dingjamesj/electronic-trombone/Flowchart.pdf

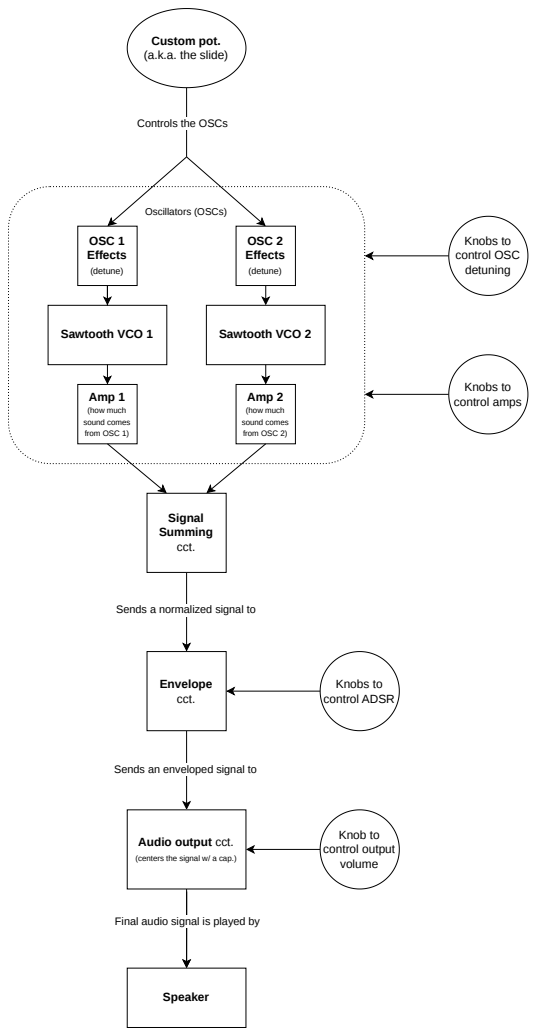
[picture p1: page 1]
Sawtooth VCO 1; Sawtooth VCO 2; Amp 1; (how much sound comes from OSC 1); Amp 2; (how much sound comes from OSC 2); OSC 1 Effects; (detune); OSC 2 Effects; Oscillators (OSCs); Signal Summing cct.; Envelope cct.; Speaker; Knobs to control ADSR; Custom pot. (a.k.a. the slide); Knobs to control OSC detuning; Knobs to control amps; Knob to control output volume

Controls the OSCs

Sends a normalized signal to

Sends an enveloped signal to

Audio output cct.

(centers the signal w/ a cap.)

Final audio signal is played by
