dingjamesj/electronic-trombone/SPICE simulation.asc

A1: schmtinv; Vhigh=9 Vt=4.45 Vh=.85 Trise=.1u Tfall=.1u
A2: schmtinv; Vhigh=9 Vt=4.45 Vh=.85 Trise=.1u Tfall=.1u
C1: cap; 2.2n
C3: cap; 2.2n
C_f: cap; 1µ
D1: diode; 1N4148
D2: diode; 1N4148
PotLeft_Coarse1: res; 49k
PotLeft_Coarse2: res; 50k
PotLeft_Fine1: res; 50k
PotLeft_Fine2: res; 50k
PotLeft_Mixer: res; 500k
PotRight_Coarse1: res; 51k
PotRight_Coarse2: res; 50k
PotRight_Fine1: res; 50k
PotRight_Fine2: res; 50k
PotRight_Mixer: res; 500k
Q1: npn
Q2: pnp
Q3: npn
Q4: pnp
R_amp1: res; 33k
R_amp2: res; 100k
R_Coarse1: res; 100k
R_Coarse2: res; 100k
R_CurrentLimit: res; 20k
R_f: res; 100k
R_Fine1: res; 1Meg
R_Fine2: res; 1Meg
R_In1: res; 100k
R_In2: res; 100k
R_Large1: res; 1Meg
R_Large2: res; 1Meg
TH_Coarse1: res; 10k
TH_Coarse2: res; 10k
TH_Fine1: res; 10k
TH_Fine2: res; 10k
TH_In1: res; 10k
TH_In2: res; 10k
U1: UniversalOpAmp2
U2: UniversalOpAmp2
U3: UniversalOpAmp2
U5: UniversalOpAmp2
V1: voltage; 12
V2: voltage; 12
V3: voltage; 12
V4: voltage; 12
V5: voltage; 12
V6: voltage; 12
V7: voltage; 12
V8: voltage; 12
V9: voltage; 12
V10: voltage; 12
V11: voltage; 12
V12: voltage; 12
V15: voltage; 12
V16: voltage; 12
V_In: voltage; 5
Named nets: 0, v1, v2, out, v4, v3
.tran 0 0.5 0.495
.ic V(v1) 0
.ic V(v2) 0
.ic V(v3) 0
.ic V(v4) 0
