dingjamesj/electronic-trombone/SPICE Simulations/Power.asc

R1: res; 25k
R2: res; 75k
R3: res; 10k
R4: res; 10k
R5: res; 10k
R6: res; 10k
R7: res; 1k
R8: res; 99999
R9: res; 1
U1: UniversalOpAmp2
U2: UniversalOpAmp2
U3: UniversalOpAmp2
V1: voltage; 9
V2: voltage; -9
V3: voltage; 5
V4: voltage; 2.5
Named nets: MuxOut, 0, VCC, VEE, VDD, Pot-, Pot+, PotOut
The custom slide pot
.tran 0 0.5 0
