dingjamesj/electronic-trombone/SPICE Simulations/EnvelopeGenerator.asc

C1: cap; 1µ
C2: cap; 1µ
C3: cap; 1µ
C4: cap; 1µ
C5: cap; 10n
D1: diode; 1N4148
D2: diode; 1N4148
D3: diode; 1N4148
D4: diode; 1N4148
D5: diode; 1N4148
D6: diode; 1N4148
D7: diode; 1N4148
D10: diode; 1N4148
D11: diode; 1N4148
R1: res; 60k
R2: res; 60k
R3: res; 100k
R4: res; 100k
R5: res; 100k
R6: res; 100k
R7: res; 5k
R8: res; 100k
R9: res; 50k
R10: res; 200k
R11: res; 1k
R12: res; 1k
R13: res; 50k
R14: res; 50k
R15: res; 100k
R16: res; 100k
R17: res; 150k
R18: res; 150k
R19: res; 100k
R20: res; 100k
R21: res; 100k
R22: res; 12k
R23: res; 75k
U1: UniversalOpAmp2
U2: UniversalOpAmp2
U3: UniversalOpAmp2
U4: UniversalOpAmp2
U5: UniversalOpAmp2
U8: UniversalOpAmp2
U9: UniversalOpAmp2
U10: UniversalOpAmp2
V1: voltage; 9
V2: voltage; 9
V3: voltage; PWL(0 -9 0.01m 0 0.3 4.5 1.2 -4.5 2 -9)
V4: voltage; PULSE(-9 0 0 0.01m 0.01m 1.2 2 1)
V5: voltage; PULSE(-9 0 0 0.01m 0.01m 0.1 0.2 4)
Named nets: VCC, VEE, 0, AmpSustain, FilterSustain, AmpOut, FilterOut, In, In0, ProcessedIn, AmpGoalVoltage, FilterGoalVoltage, In2
Sustain is half of VCC, decay is 0V
Amp Envelope
Filter Envelope
Low pass filter with two cutoff freqs depending on the difference between the goal voltage and the current output voltage.
Same as above
.tran 2
An input greater than -4.5V triggers the envelope generator.
-4.5V was chosen instead of 0V because some input signals will be 0V or less.
Recall that this input voltage is also the VCO's control voltage, and the VCO's control voltage can range all the way down to 0V.
Controls slope of the attack
Controls length & slope of decay and release
Controls length
Protects op amp input
from negative voltage swing
of the attack
Makes envelope go to sustain/base voltage
instead of VEE
Same here
These nodes are VCC during the attack, at the sustain voltage during sustain, and at GND otherwise.
It's the voltage that we're trying to "reach."
Test performance during repeated presses
Test performance under "test conditions"
i.e. a single, long pulse of one voltage
Test performance during slide movement
i.e. a single pulse with changing voltage
