dingjamesj/electronic-trombone/SPICE Simulations/Filter.asc

C1: cap; 1n
C2: cap; 1n
C3: cap; 1n
D1: diode; 1N4148
D2: diode; 1N4148
D3: diode; 1N4148
D4: diode; 1N4148
D5: diode; 1N4148
D6: diode; 1N4148
D7: diode; 1N4148
R1: res; 10k
R2: res; 1k
R6: res; 10k
R7: res; 10k
R9: res; 10k
R10: res; 10k
R11: res; 10k
R12: res; 10k
R13: res; 10k
U1: UniversalOpAmp2
U2: UniversalOpAmp2
U3: UniversalOpAmp2
U6: UniversalOpAmp2
U8: UniversalOpAmp2
V1: voltage; 0.5
V2: voltage; 9
V3: voltage; 9
V4: voltage; ""; AC 1
Named nets: 0, VCC, VEE, ControlIn, ProcessedControlIn, SignalIn, UnprocessedOut, Out
Control Processing
The Filter
Output Processing
This amplifies the signal into the required pp voltage and provides a voltage follower at the end.
Diode ladder
Attenuates the control signal such that its range satisfies the range required by the diode ladder.
.ac dec 100 1 100k
.step param ControlVoltage 0 1 0.1
