dingjamesj/electronic-trombone/SPICE Simulations/Oscillator.asc

A1: schmtinv; Vhigh=9 Vt=4.45 Vh=.85 Trise=.1u Tfall=.1u
A2: schmtinv; Vhigh=9 Vt=4.45 Vh=.85 Trise=.1u Tfall=.1u
C1: cap; 2.2n
C3: cap; 2.2n
C_f1: cap; 1µ
D1: diode; 1N4148
D2: diode; 1N4148
PotLeft_Coarse1: res; 50k
PotLeft_Coarse2: res; 50k
PotLeft_Fine1: res; 50k
PotLeft_Fine2: res; 50k
PotLeft_Mixer: res; 50k
PotRight_Coarse1: res; 50k
PotRight_Coarse2: res; 50k
PotRight_Fine1: res; 50k
PotRight_Fine2: res; 50k
PotRight_Mixer: res; 50k
Q1: npn
Q2: pnp
Q3: npn
Q4: pnp
R1: res; 90k
R2: res; 10k
R_Coarse1: res; 100k
R_Coarse2: res; 100k
R_Fine1: res; 1Meg
R_Fine2: res; 1Meg
R_In1: res; 100k
R_In2: res; 100k
R_Large1: res; 1Meg
R_Large2: res; 1Meg
R_Scaling1: res; 2.5k
R_Scaling2: res; 2.5k
TH_Coarse1: res; 10k
TH_Coarse2: res; 10k
TH_Fine1: res; 10k
TH_Fine2: res; 10k
TH_In1: res; 10k
TH_In2: res; 10k
U1: UniversalOpAmp2
U2: UniversalOpAmp2
U3: UniversalOpAmp2
U6: UniversalOpAmp2
V1: voltage; 3.5
V3: voltage; 7
V4: voltage; 7
Named nets: 0, v1, v2, Out, v4, v3, In1, In2, mixsum, VCC, VEE, In
.tran 0 5 4.98
