dingjamesj/electronic-trombone/SPICE Simulations/Amplifier.asc

C1: cap; 1µ
Q1: npn; 2N2222
Q2: npn; 2N2222
R1: res; 10k
R2: res; 2.7k
R3: res; 2.7k
R4: res; 100k
R5: res; 100k
R6: res; 10k
R7: res; 10k
R10: res; 100k
U1: UniversalOpAmp2
U2: UniversalOpAmp2
U3: UniversalOpAmp2
U4: UniversalOpAmp2
V1: voltage; 9
V2: voltage; -9
V3: voltage; SINE(0 5m 440)
V4: voltage; -1.5
Named nets: SignalIn, ControlIn, VCC, VEE, 0, Out
10mV pp
.tran 0 5 4.98
