dingjamesj/electronic-trombone/SPICE Simulations/Envelope Generator.asc

C1: cap; 1µ
C2: cap; 1µ
C3: cap; 1µ
D1: diode; 1N4148
D2: diode; 1N4148
D3: diode; 1N4148
D4: diode; 1N4148
D5: diode; 1N4148
D6: diode; 1N4148
D7: diode; 1N4148
D8: diode; 1N4148
D9: diode; 1N4148
R1: res; 50k
R2: res; 50k
R3: res; 100k
R4: res; 100k
R5: res; 100k
R6: res; 100k
R7: res; 10k
R8: res; 100k
R9: res; 10k
R10: res; 100k
R11: res; 1k
R12: res; 1k
R13: res; 50k
R14: res; 25k
R15: res; 50k
R16: res; 25k
U1: UniversalOpAmp2
U2: UniversalOpAmp2
U3: UniversalOpAmp2
U4: UniversalOpAmp2
U5: UniversalOpAmp2
U6: UniversalOpAmp2
U7: UniversalOpAmp2
V1: voltage; 9
V2: voltage; 9
Named nets: In, TriggerRef, VCC, VEE, 0, Sustain1, Sustain2, Out1, Out2
Set to 4.5 V
Set to half the maximum (-3 dB)
Also set to half the maximum (-3 dB)
Envelope Output 1
Envelope Output 2
Controls release & decay
According to Mortiz Klein, controls attack. However, the simulation disagrees.
Same as above
Controls how long the envelope will initially increase for (i.e. controls attack)
