dingjamesj/electronic-trombone/KiCad/Buttons/Buttons.kicad_pcb

## KiCad design KiCad/Buttons/Buttons.kicad_pcb (2026-08-21)

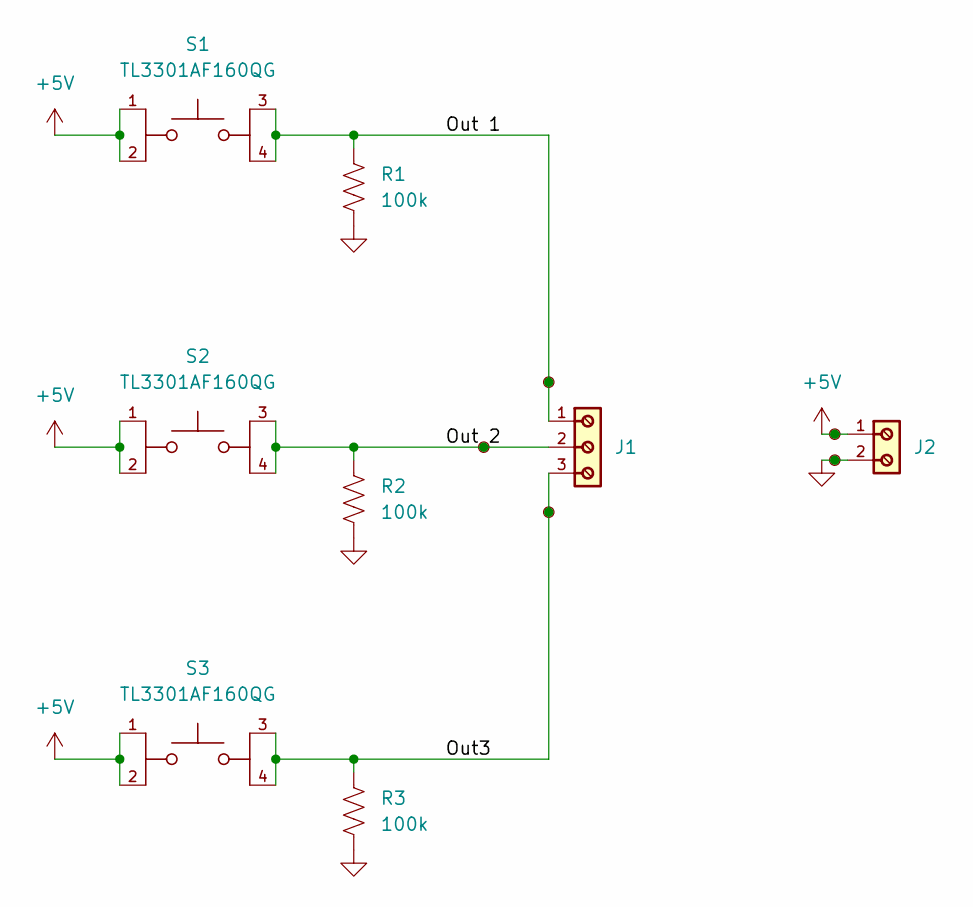
[picture p2: schematic Buttons.kicad_sch]

Parts:
J1: 691137710003
J2: 691137710002
R1, R2, R3: 100k; R_Axial_DIN0207_L6.3mm_D2.5mm_P7.62mm_Horizontal
S1, S2, S3: TL3301AF160QG; SW_TL3301AF160QG; PARTREV E
TP1, TP2, TP3, TP4, TP5: TestPoint_Small; TestPoint_Keystone_5000-5004_Miniature

Connections:
+5V: J2.1, S1.1, S1.2, S2.1, S2.2, S3.1, S3.2, TP2.1 (1_1)
/Out3: J1.3, R3.1, S3.3, S3.4, TP5.1 (1_1)
/Out 1: J1.1, R1.1, S1.3, S1.4, TP3.1 (1_1)
/Out 2: J1.2, R2.1, S2.3, S2.4, TP4.1 (1_1)
GND: J2.2, R1.2, R2.2, R3.2, TP1.1 (1_1)

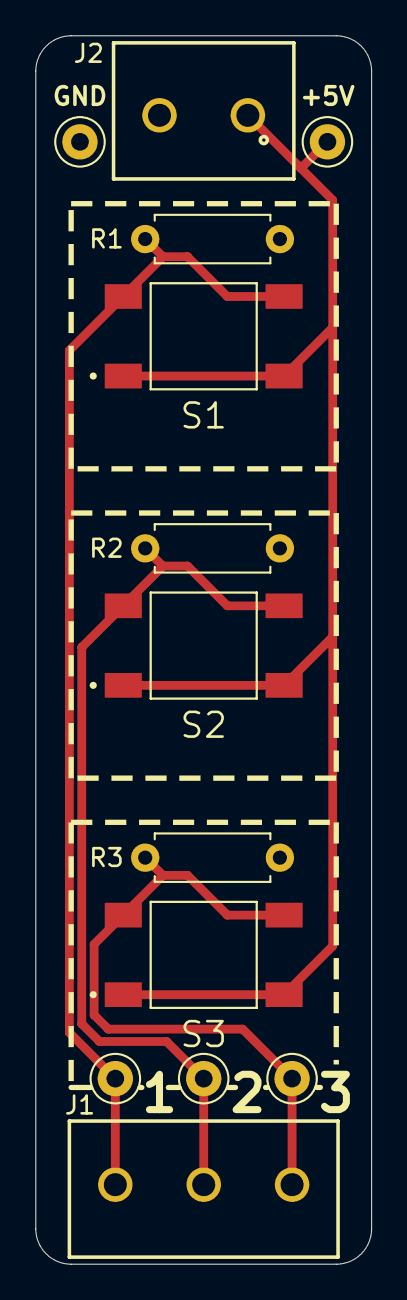
[picture p3: board Buttons.kicad_pcb from above]

Board: 2 copper layers, 19.0 x 69.5 mm, 13 parts (0 on the bottom side), 5 nets.
