dingjamesj/electronic-trombone/KiCad/Main/Main.kicad_pcb

## KiCad design KiCad/Main/Main.kicad_pcb (2026-08-21)

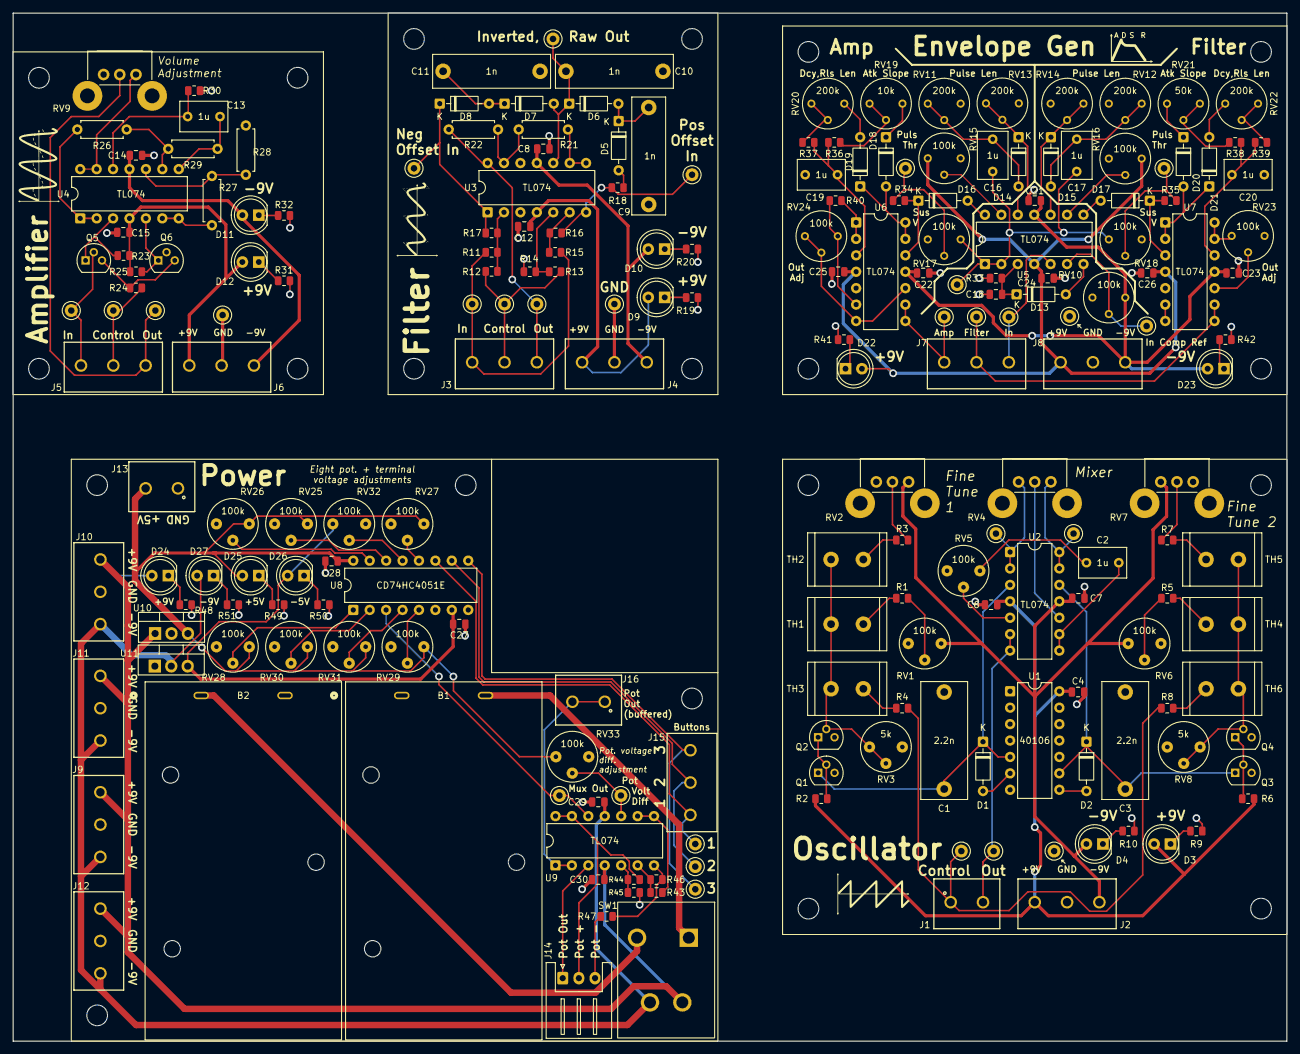
[picture p4: board Main.kicad_pcb from above]

Board: 2 copper layers, 197.0 x 159.0 mm, 231 parts (0 on the bottom side), 127 nets.

Parts:
B1, B2: BC9VPC; BC9VPC_MPD
C1, C3: 2.2n; C_Rect_L18.0mm_W7.0mm_P15.00mm_FKS3_FKP3
C2, C13, C16, C17, C19, C20: 1u; C_Rect_L7.2mm_W4.5mm_P5.00mm
C4, C6, C7, C8, C12, C14, C15, C21, C22, C23, C24, C25, C26, C27, C28, C29, C30: 0.1u; C_0805_2012Metric
C9, C10, C11: 1n; C_Rect_L18.0mm_W5.0mm_P15.00mm_FKS3_FKP3
C18: 10n; C_0805_2012Metric
D1, D2, D5, D6, D7, D8, D13, D14, D15, D16, D17, D18, D19, D20, D21: 1N4148; D_DO-35_SOD27_P7.62mm_Horizontal
D3, D4, D9, D10, D11, D12, D22, D23, D24, D25, D26, D27: LED; LED_D5.0mm
H1, H2, H3, H4: MountingHole_3.2mm_M3
H5, H6, H7, H8, H9, H10, H11, H12, H13, H14, H15, H16, H17, H18, H19, H20: MountingHole; MountingHole_3.2mm_M3
J1, J13, J16: Screw_Terminal_01x02; 691137710002
J2, J3, J4, J5, J6, J7, J8, J9, J10, J11, J12, J15: Screw_Terminal_01x03; 691137710003
J14: Conn_01x03; JST_XH_S3B-XH-A_1x03_P2.50mm_Horizontal
Q1, Q3, Q5, Q6: NPN; TO-92
Q2, Q4: PNP; TO-92
R1, R4, R5, R8, R23, R25, R30, R33, R34, R35: 100k; R_0805_2012Metric
R2, R3, R6, R7: 1M; R_0805_2012Metric
R9, R10, R19, R20, R31, R32, R36, R41, R42, R47, R48, R51: 1k; R_0805_2012Metric
R11, R12, R13, R14, R15, R16, R17, R24, R43, R44, R45, R46: 10k; R_0805_2012Metric
R18: 2.2k; R_0805_2012Metric
R21, R28, R29: 10k; R_Axial_DIN0207_L6.3mm_D2.5mm_P7.62mm_Horizontal
R22: 1k; R_Axial_DIN0207_L6.3mm_D2.5mm_P7.62mm_Horizontal
R26, R27: 2.7k; R_Axial_DIN0207_L6.3mm_D2.5mm_P7.62mm_Horizontal
R37, R39, R40: 51k; R_0805_2012Metric
R38: 22k; R_0805_2012Metric
R49, R50: 820; R_0805_2012Metric
RV1, RV5, RV6, RV25, RV26, RV27, RV28, RV29, RV30, RV31, RV32, RV33: 100k; Potentiometer_Bourns_3339P_Vertical_HandSoldering
RV2, RV4, RV7, RV9: 100k; Potentiometer_Bourns_PTV09A-2_Single_Horizontal
RV3, RV8: 5k; Potentiometer_Bourns_3339P_Vertical_HandSoldering
RV10, RV15, RV16, RV17, RV18, RV23, RV24: 100k; Potentiometer_Bourns_3339P_Vertical
RV11, RV12, RV13, RV14, RV20, RV22: 200k; Potentiometer_Bourns_3339P_Vertical
RV19: 10k; Potentiometer_Bourns_3339P_Vertical
RV21: 50k; Potentiometer_Bourns_3339P_Vertical
SW1: SW_DPST; DPST Switch RA83231100
TH1, TH2, TH3, TH4, TH5, TH6: 10k; R_Radial_Power_L12.0mm_W8.0mm_P5.00mm
TP1, TP2, TP3, TP4, TP5, TP6, TP7, TP8, TP9, TP10, TP11, TP12, TP13, TP14, TP15, TP16, TP17, TP18, TP19, TP20, TP21, TP22, TP23, TP24, TP25, TP26, TP27, TP28, TP29: TestPoint_Small; TestPoint_Keystone_5000-5004_Miniature
U1: 40106; DIP-14_W7.62mm
U2, U3, U4, U5, U6, U7, U9: TL074; DIP-14_W7.62mm
U8: CD74HC4051E; DIP-16_W7.62mm
U10: L7805; TO-220-3_Vertical
U11: L7905; TO-220-3_Vertical

Connections:
+5V: C28.2, D25.2 (A), J13.2, RV25.1, RV26.1, RV27.1, RV28.1, RV29.1, RV30.1, RV31.1, RV33.3, U8.16 (VCC), U10.3 (OUT)
+9V: C4.1, C6.1, C12.2, C15.2, C24.2, C25.2, C26.2, C30.2, D3.2 (A), D9.2 (A), D11.2 (A), D22.2 (A), D24.2 (A), J2.1, J4.1, J6.1, J8.1, J9.1, J10.1, J11.1, J12.1, R2.1, R6.1, R23.1, R25.1, RV15.3, RV16.1, SW1.2, U1.14 (VDD), U2.4 (V+), U3.4 (V+), U4.4 (V+), U5.4 (V+), U6.4 (V+), U7.4 (V+), U9.4 (V+), U10.1 (IN)
-5V: C27.1, D26.2 (A), RV32.3, U8.7 (VEE), U11.3 (VO)
-9V: C7.2, C8.1, C14.1, C21.1, C22.1, C23.1, C29.1, D4.2 (A), D10.2 (A), D12.2 (A), D23.2 (A), D27.2 (A), J2.3, J4.3, J6.3, J8.3, J9.3, J10.3, J11.3, J12.3, RV1.1, RV2.1, RV6.3, RV7.3, RV10.1, SW1.4, U2.11 (V-), U3.11 (V-), U4.11 (V-), U5.11 (V-), U6.11 (V-), U7.11 (V-), U9.11 (V-), U11.2 (VI)
/Buffered Inverted Raw Out: R21.1, U3.8, U3.9 (-)
/Buffered Pot Out: J16.1, J16.2, U9.1, U9.2 (-)
/Button 1: J15.1, TP25.1 (1_1), U8.11 (S0)
/Button 2: J15.2, TP26.1 (1_1), U8.10 (S1)
/Button 3: J15.3, TP27.1 (1_1), U8.9 (S2)
/Control: J3.2, J5.2, R12.1, R13.2, R24.2, TP7.1 (1_1), TP14.1 (1_1)
/Envelope Generator/Amp Burst: D16.2 (A), U5.14
/Envelope Generator/Amp Out: J7.1, TP21.1 (1_1), U6.8, U6.9 (-)
/Envelope Generator/Amp Sustain/Base Voltage: R34.2, RV17.2, TP19.1 (1_1)
/Envelope Generator/Amp Target Voltage: D18.2 (A), D19.1 (K), U6.13 (-), U6.14
/Envelope Generator/Filter Burst: D17.2 (A), U5.8
/Envelope Generator/Filter Out: J7.2, TP22.1 (1_1), U7.8, U7.9 (-)
/Envelope Generator/Filter Sustain/Base Voltage: R35.2, RV18.2, TP20.1 (1_1)
/Envelope Generator/Filter Target Voltage: D20.2 (A), D21.1 (K), U7.1, U7.2 (-)
/Envelope Generator/In: J7.3, TP23.1 (1_1), U5.5 (+)
/Envelope Generator/Input Comparator Ref: RV10.2, TP17.1 (1_1), U5.6 (-)
/Envelope Generator/Normalized In: C16.1, C17.1, RV17.1, RV18.3, TP18.1 (1_1), U5.1, U5.2 (-)
/Envelope Generator/Unscaled Amp Out: R40.1, U6.1, U6.2 (-)
/Envelope Generator/Unscaled Filter Out: RV23.3, U7.13 (-), U7.14
/In: J3.1, J5.1, Q5.2 (B), R11.1, R15.1, TP6.1 (1_1), TP13.1 (1_1)
/Inverted Raw Out: C10.2, D6.1 (K), D7.2 (A), TP12.1 (1_1), U3.10 (+)
/Mux Out: TP28.1 (1_1), U8.3 (A), U9.12 (+)
/Oscillator/Control: J1.1, R4.1, R8.1, TP3.1 (1_1)
/Oscillator/Mix In 1: RV4.3, TP1.1 (1_1), U2.1, U2.2 (-)
/Oscillator/Mix In 2: RV4.1, TP2.1 (1_1), U2.13 (-), U2.14
/Oscillator/Out: J1.2, TP4.1 (1_1), U2.6 (-), U2.7
/Oscillator/Processed Control 1: Q2.2 (B), RV3.2, RV3.3, TH1.2, TH2.2, TH3.2
/Oscillator/Processed Control 2: Q4.2 (B), RV8.1, RV8.2, TH4.2, TH5.2, TH6.2
/Oscillator/Sch Inv In 1: C1.1, D1.1 (K), Q1.1 (C), U1.5, U2.3 (+)
/Oscillator/Sch Inv In 2: C3.1, D2.1 (K), Q3.1 (C), U1.9, U2.12 (+)
/Oscillator/Sch Inv Out 1: D1.2 (A), U1.6
/Oscillator/Sch Inv Out 2: D2.2 (A), U1.8
/Out: J3.3, J5.3, R22.2, RV9.2, TP8.1 (1_1), TP15.1 (1_1), U3.14
/Pot +: J14.2, R44.1, U9.13 (-), U9.14
/Pot -: J14.3, R47.2
/Pot Out: J14.1, U9.3 (+)
/Pot Voltage Difference: RV33.2, TP29.1 (1_1), U9.10 (+)
/Pot+ 1st Partial: RV25.2, U8.14 (A1)
/Pot+ 2nd Partial: RV26.2, U8.15 (A2)
/Pot+ 3rd Partial: RV27.2, U8.12 (A3)
/Pot+ 4th Partial: RV28.2, U8.1 (A4)
/Pot+ 5th Partial: RV29.2, U8.5 (A5)
/Pot+ 6th Partial: RV30.2, U8.2 (A6)
/Pot+ 7th Partial: RV31.2, U8.4 (A7)
/Pot+ Inactive: RV32.2, U8.13 (A0)
/Power/Thaw 3: U7.6 (-), U7.7
/Signal w. + Offset: R16.2, R18.1, TP10.1 (1_1), U3.7
/Signal w. - Offset: D8.1 (K), R17.2, TP11.1 (1_1), U3.1
GND: B1.1, B2.2, C1.2, C3.2, C4.2, C6.2, C7.1, C8.2, C9.1, C10.1, C11.1, C12.1, C14.2, C15.1, C18.2, C19.1, C20.1, C21.2, C22.2, C23.2, C24.1, C25.1, C26.1, C27.2, C28.1, C29.2, C30.1, J2.2, J4.2, J6.2, J8.2, J9.2, J10.2, J11.2, J12.2, J13.1, Q1.3 (E), Q2.3 (E), Q3.3 (E), Q4.3 (E), Q6.2 (B), R9.2, R10.2, R14.1, R19.2, R20.2, R28.2, R30.2, R31.2, R32.2, R33.2, R41.2, R42.2, R45.1, R48.2, R49.2, R50.2, R51.2, RV1.3, RV2.3, RV3.1, RV5.3, RV6.1, RV7.1, RV8.3, RV9.3, RV10.3, RV11.1, RV12.3, RV13.1, RV14.3, RV15.1, RV16.3, RV17.3, RV18.1, RV23.1, RV25.3, RV26.3, RV27.3, RV28.3, RV29.3, RV30.3, RV31.3, RV32.1, RV33.1, TP5.1 (1_1), TP9.1 (1_1), TP16.1 (1_1), TP24.1 (1_1), U1.1, U1.3, U1.7 (VSS), U1.11, U1.13, U3.3 (+), U3.12 (+), U6.5 (+), U7.5 (+), U8.6 (*E), U8.8 (GND), U10.2 (GND), U11.1 (GND)
unnamed: B1.2, SW1.1
unnamed: B2.1, SW1.3
unnamed: C2.2, RV5.1
unnamed: C13.1, R29.2, U4.8
unnamed: D3.1 (K), R9.1
unnamed: D4.1 (K), R10.1
unnamed: D5.2 (A), R18.2
unnamed: C9.2, D5.1 (K), D6.2 (A)
unnamed: C11.2, D7.1 (K), D8.2 (A)
unnamed: D9.1 (K), R19.1
unnamed: D10.1 (K), R20.1
unnamed: D11.1 (K), R31.1
unnamed: D12.1 (K), R32.1
unnamed: D13.2 (A), U5.7
unnamed: C18.1, D13.1 (K), R33.1, U5.3 (+)
unnamed: C16.2, D14.2 (A), RV11.2, RV11.3
unnamed: D14.1 (K), RV13.2, RV13.3, U5.12 (+)
unnamed: C17.2, D15.2 (A), RV12.1, RV12.2
unnamed: D15.1 (K), RV14.1, RV14.2, U5.10 (+)
unnamed: D16.1 (K), R34.1, U6.12 (+)
unnamed: D17.1 (K), R35.1, U7.3 (+)
unnamed: D18.1 (K), RV19.1
unnamed: D19.2 (A), RV20.1
unnamed: D20.1 (K), RV21.3
unnamed: D21.2 (A), RV22.3
unnamed: D22.1 (K), R41.1
unnamed: D23.1 (K), R42.1
unnamed: D24.1 (K), R48.1
unnamed: D25.1 (K), R49.1
unnamed: D26.1 (K), R50.1
unnamed: D27.1 (K), R51.1
unnamed: Q1.2 (B), Q2.1 (C), R2.2
unnamed: Q3.2 (B), Q4.1 (C), R6.2
unnamed: Q5.1 (C), R23.2, U4.3 (+)
unnamed: Q5.3 (E), Q6.3 (E), R24.1
unnamed: Q6.1 (C), R25.2, U4.5 (+)
unnamed: R1.1, RV1.2
unnamed: R1.2, TH1.1
unnamed: R3.1, RV2.2
unnamed: R3.2, TH2.1
unnamed: R4.2, TH3.1
unnamed: R5.1, RV6.2
unnamed: R5.2, TH4.1
unnamed: R7.1, RV7.2
unnamed: R7.2, TH5.1
unnamed: R8.2, TH6.1
unnamed: R36.1, RV19.2, RV19.3
unnamed: R37.1, RV20.2, RV20.3
unnamed: R38.1, RV21.1, RV21.2
unnamed: R39.1, RV22.1, RV22.2
unnamed: R46.2, R47.1, U9.7
unnamed: RV5.2, U2.5 (+)
unnamed: RV4.2, U2.10 (+)
unnamed: C2.1, U2.8, U2.9 (-)
unnamed: R11.2, R12.2, R17.1, U3.2 (-)
unnamed: R13.1, R14.2, U3.5 (+)
unnamed: R15.2, R16.1, U3.6 (-)
unnamed: R21.2, R22.1, U3.13 (-)
unnamed: R26.1, U4.1, U4.2 (-)
unnamed: R27.1, U4.6 (-), U4.7
unnamed: R27.2, R28.1, U4.10 (+)
unnamed: R26.2, R29.1, U4.9 (-)
unnamed: C13.2, R30.1, U4.12 (+)
unnamed: RV9.1, U4.13 (-), U4.14
unnamed: RV16.2, U5.9 (-)
unnamed: RV15.2, U5.13 (-)
unnamed: C19.2, R36.2, R37.2, U6.3 (+)
unnamed: R40.2, RV24.1, U6.6 (-)
unnamed: RV24.2, RV24.3, U6.7, U6.10 (+)
unnamed: RV23.2, U7.10 (+)
unnamed: C20.2, R38.2, R39.2, U7.12 (+)
unnamed: R44.2, R45.2, U9.5 (+)
unnamed: R43.2, R46.1, U9.6 (-)
unnamed: R43.1, U9.8, U9.9 (-)
