dingjamesj/electronic-trombone/(commit log)

2026-05-22 re-initalize project as KiCad project
    [Electronic Trombone.kicad_pcb, Electronic Trombone.kicad_sch]
2026-05-27 completed oscillator schematic
    [Electronic Trombone.kicad_sch]
2026-05-27 reorganized project files
    [Oscillator.kicad_pcb, Oscillator.kicad_sch]
2026-06-02 added resistor values to the osc.'s amp. cct.
    [Oscillator.kicad_sch]
2026-06-08 added power supply pcb
    [Power Supply.kicad_pcb, Power Supply.kicad_sch]
2026-06-08 added mixer into circuit
    [Oscillator.kicad_sch]
2026-06-09 removed unnecessary buffers in front of each osc.
    Also put LTspice simulation files in their own folder
    [Oscillator.kicad_sch]
2026-06-11 unified kicad projects, added footprints
    [Envelope Generator.kicad_sch, Main.kicad_sch, Oscillator.kicad_pcb, Oscillator.kicad_sch, Power Supply.kicad_pcb, Power Supply.kicad_sch]
2026-06-11 renamed main schematic file, annotations start at 0
    [Electronic Trombone.kicad_sch, Oscillator.kicad_sch]
2026-06-11 SPICE simulation now uses 9V instead of 12V
2026-06-13 amplifier sch., general changes to oscillator sch.
    [Amplifier.kicad_sch, Electronic Trombone.kicad_sch, Envelope Generator.kicad_sch, Filter.kicad_sch, Oscillator.kicad_sch, Power Supply.kicad_sch]
2026-06-14 improved osc.'s output buffer cct., swap filter & amp
    [Amplifier.kicad_sch, Electronic Trombone.kicad_sch, Filter.kicad_sch, Oscillator.kicad_sch]
2026-06-14 made filter's core, but not CV and output ccts.
    [Filter.kicad_sch]
2026-06-14 added critical trimmer resistor that the osc. was missing
    The trimmer resistor serves in a voltage divider to the osc.'s input signal. Without that voltage divider, the coarse tuning knob's range is too large (i.e. it's too coarse) and therefore unusable (according to the LTspice simualtions).
    [Filter.kicad_sch, Oscillator.kicad_sch]
2026-06-14 drafted filter schematic
    [Amplifier.kicad_sch, Electronic Trombone.kicad_sch, Filter.kicad_sch, Oscillator.kicad_sch]
2026-06-14 drafted a dual output envelope generator
    [Electronic Trombone.kicad_sch, Envelope Generator.kicad_sch]
2026-06-20 replaced some pots with voltage dividers, ltspice qol
    [Envelope Generator.kicad_sch, Oscillator.kicad_sch]
2026-06-20 created SPICE sim for Voltage Controlled Filter
    [Filter.kicad_sch]
2026-06-21 drafted envelope generator LTspice simulation
    [Envelope Generator.kicad_sch]
2026-06-21 drafted voltage controlled amplifier SPICE sim.
    [Amplifier.kicad_sch]
2026-06-22 wrote ac analysis for filter, stepping through CVs
    I was trying to find the relationship between the filter's cutoff frequency and the its control voltage. As it turns out, the relationship is exponential (i.e. a linear increase in CV results in an exponential increase in cutoff freq).
    [Electronic Trombone.kicad_sch]
2026-06-23 created a symbol for the filter
2026-06-23 gave symbols to the remaining schematics
2026-06-24 fixed filter cct to output 10mV pp
2026-06-26 finalizing schematic
    [Amplifier.kicad_sch, Electronic Trombone.kicad_sch, Envelope Generator.kicad_sch, Filter.kicad_sch, Oscillator.kicad_sch]
2026-06-29 updated footprints
    [Amplifier.kicad_sch, Electronic Trombone.kicad_sch, Envelope Generator.kicad_sch, Filter.kicad_sch, Oscillator.kicad_sch]
2026-06-29 added potentiometer voltage control cct
    [Amplifier.kicad_sch, Electronic Trombone.kicad_sch, Envelope Generator.kicad_sch, Filter.kicad_sch, Oscillator.kicad_sch, buttons.kicad_sch]
2026-06-29 added push button footprints
    [Electronic Trombone.kicad_sch, Filter.kicad_sch, buttons.kicad_sch]
2026-06-29 renamed button controls schematic file
    [Button Controls.kicad_sch]
2026-06-29 added volume control knob
    [Amplifier.kicad_sch, Button Controls.kicad_sch, Electronic Trombone.kicad_pcb, Electronic Trombone.kicad_sch, Envelope Generator.kicad_sch, Filter.kicad_sch, Oscillator.kicad_sch]
2026-06-30 added power switch, decoupling caps, and unused IC pins
    [Amplifier.kicad_sch, Button Controls.kicad_sch, Electronic Trombone.kicad_pcb, Electronic Trombone.kicad_sch, Envelope Generator.kicad_sch, Filter.kicad_sch, Oscillator.kicad_sch, Power.kicad_sch]
2026-07-01 started pcb layout
    [Electronic Trombone.kicad_pcb, Electronic Trombone.kicad_sch, Oscillator.kicad_sch, Power.kicad_sch]
2026-07-01 added osc core and tuning to pcb layout
    [Electronic Trombone.kicad_pcb, Electronic Trombone.kicad_sch, Oscillator.kicad_sch, Power.kicad_sch]
2026-07-01 added osc output processing to pcb layout
    [Electronic Trombone.kicad_pcb]
2026-07-02 minor but important changes to schematic
    [Electronic Trombone.kicad_pcb, Electronic Trombone.kicad_sch, Power.kicad_sch]
2026-07-03 fixed custom pot voltage control schematic
    [Custom Potentiometer Controls.kicad_sch, Electronic Trombone.kicad_pcb, Electronic Trombone.kicad_sch, Power.kicad_sch]
2026-07-03 placed and routed custom pot control
    [Custom Potentiometer Controls.kicad_sch, Electronic Trombone.kicad_pcb]
2026-07-03 corrected push button's symbol on schematic
    [Button Controls.kicad_sch, Electronic Trombone.kicad_pcb]
2026-07-04 routed oscillator
    [Custom Potentiometer Controls.kicad_sch, Electronic Trombone.kicad_pcb, Oscillator.kicad_sch, Power.kicad_sch]
2026-07-04 started filter layout
    [Electronic Trombone.kicad_pcb, Filter.kicad_sch, Oscillator.kicad_sch]
2026-07-05 routed the filter, updated 0201 footprints to 0402
    JLCPCB's economy PCBA has a footprint bottom limit of 0402 imperial
    [Amplifier.kicad_sch, Button Controls.kicad_sch, Custom Potentiometer Controls.kicad_sch, Electronic Trombone.kicad_pcb, Electronic Trombone.kicad_sch, Envelope Generator.kicad_sch, Filter.kicad_sch, Oscillator.kicad_sch]
2026-07-05 amplifier layout and routing
    [Electronic Trombone.kicad_pcb, Electronic Trombone.kicad_sch, Power.kicad_sch]
2026-07-05 placed missing decoupling caps next to ICs
    [Electronic Trombone.kicad_pcb]
2026-07-07 placed and routed envelope core
    [Electronic Trombone.kicad_pcb, Electronic Trombone.kicad_sch, Envelope Generator.kicad_sch, Power.kicad_sch]
2026-07-07 routed rest of the envelope generator
    [Electronic Trombone.kicad_pcb, Electronic Trombone.kicad_sch, Power.kicad_sch]
2026-07-08 checkpoint before attempt to reroute power traces
    [Electronic Trombone.kicad_pcb]
2026-07-08 second checkpoint before complete redo of pcb
    [Electronic Trombone.kicad_pcb, Electronic Trombone.kicad_sch]
2026-07-08 Revert "second checkpoint before complete redo of pcb"
    This reverts commit 4d5d4d4b5e4cbbcaee48991b351946aeae31b1e5.
    [Electronic Trombone.kicad_pcb, Electronic Trombone.kicad_sch]
2026-07-08 completed first draft
    [Electronic Trombone-B_Cu.gbl, Electronic Trombone-B_Mask.gbs, Electronic Trombone-B_Paste.gbp, Electronic Trombone-B_Silkscreen.gbo, Electronic Trombone-Edge_Cuts.gm1, Electronic Trombone-F_Cu.gtl, Electronic Trombone-F_Mask.gts, Electronic Trombone-F_Paste.gtp]
2026-07-09 all SMD are 0603 (imperial) now, started rerouting all traces
    [Amplifier.kicad_sch, Button Controls.kicad_sch, Custom Potentiometer Controls.kicad_sch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]
2026-07-09 improved power routing
    [Electronic Trombone.kicad_pcb]
2026-07-15 first JLCPCB order
    [Electronic Trombone.kicad_pcb, Electronic Trombone.kicad_sch, Power.kicad_sch]
2026-08-12 started separating into different boards, partially fixed envelope generator
    [Amplifier.kicad_pcb, Amplifier.kicad_sch, Button Controls.kicad_sch, Buttons.kicad_pcb, Buttons.kicad_sch, Custom Potentiometer Controls.kicad_sch, Electronic Trombone Oscillator.kicad_sch, Envelope Generator.kicad_pcb]
2026-08-13 fixed envelope generator
    [Envelope Generator.kicad_sch]
2026-08-13 completed envelope generator schematic
    [Envelope Generator.kicad_sch, power.kicad_sch]
2026-08-13 fixed power board, replaced sketchy voltage divider - op amp cct. with an LDO to product +5V
    [Amplifier.kicad_sch, Buttons.kicad_sch, Envelope Generator.kicad_sch, Filter.kicad_sch, Power.kicad_sch, power.kicad_sch]
2026-08-13 finished separating into separate kicad projects
    [Amplifier.kicad_sch, Button Controls.kicad_sch, Custom Potentiometer Controls.kicad_sch, Electronic Trombone Oscillator.kicad_sch, Envelope Generator.kicad_sch, Filter.kicad_sch, Oscillator.kicad_sch, Power.kicad_sch]
2026-08-13 fixed critical issue in oscillator
    schmitt trigger's VEE is supposed to be 0V, not -9V :wilted_rose: :wilted_rose:
    [Oscillator.kicad_sch, Power.kicad_sch]
2026-08-14 made oscillator more adjustable
    [Amplifier.kicad_sch, Oscillator.kicad_sch, Power.kicad_sch]
2026-08-14 added test points
    [Amplifier.kicad_sch, Buttons.kicad_sch, Envelope Generator.kicad_sch, Filter.kicad_sch, Oscillator.kicad_sch, Power.kicad_sch, power.kicad_sch]
2026-08-14 added power indicator LEDs
    [Amplifier.kicad_sch, Buttons.kicad_sch, Envelope Generator.kicad_sch, Filter.kicad_sch, Oscillator.kicad_sch, Power.kicad_sch, power.kicad_sch]
2026-08-15 amplifier pcb layout done
    [Amplifier.kicad_pcb, Amplifier.kicad_sch]
2026-08-16 removed unnecessary buffer before filter's output
    this drops the number of op amps from 5 to 4, allowing us to use 1 IC instead of 2 ICs with 3 unused circuits.
    [Amplifier.kicad_pcb, Amplifier.kicad_sch, Filter.kicad_pcb, Filter.kicad_sch]
2026-08-16 filter pcb layout done
    [Amplifier.kicad_pcb, Filter.kicad_pcb]
2026-08-16 updated footprints in oscillator
    [Oscillator.kicad_sch, Power.kicad_sch]
2026-08-16 updated footprints in envelope generator
    [Envelope Generator.kicad_sch, power.kicad_sch]
2026-08-17 oscillator pcb layout done
    [Amplifier.kicad_pcb, Envelope Generator.kicad_pcb, Envelope Generator.kicad_sch, Oscillator.kicad_pcb, Oscillator.kicad_sch, Power.kicad_sch]
2026-08-17 power pcb layout done
    [Amplifier.kicad_pcb, Filter.kicad_pcb, Oscillator.kicad_pcb, Oscillator.kicad_sch, Power.kicad_pcb, Power.kicad_sch]
2026-08-18 added mounting holes to schematics, adjusted board sizes
    [Amplifier.kicad_pcb, Amplifier.kicad_sch, Buttons.kicad_sch, Envelope Generator.kicad_sch, Filter.kicad_pcb, Filter.kicad_sch, Oscillator.kicad_pcb, Oscillator.kicad_sch]
2026-08-18 envelope generator pcb layout done
    [Envelope Generator.kicad_pcb, Envelope Generator.kicad_sch, Power.kicad_pcb, power.kicad_sch]
2026-08-18 made corners even more round on all boards
    [Amplifier.kicad_pcb, Filter.kicad_pcb, Oscillator.kicad_pcb, Power.kicad_pcb]
2026-08-19 added informational silkscreen to envelope generator
    [Envelope Generator.kicad_pcb]
2026-08-19 Update Envelope Generator.kicad_pcb
    [Envelope Generator.kicad_pcb]
2026-08-19 buttons pcb layout done
    [Buttons.kicad_pcb, Buttons.kicad_sch]
2026-08-19 changed buttons pcb layout to be smaller
    [Buttons.kicad_pcb, Buttons.kicad_sch]
2026-08-20 updated power board to have more terminals
    before, the power board had only one terminal for power supply, so the other boards would share this terminal. now, the power board has a terminal for each other board, so the other boards don't need to share the same terminal for power
    [Power.kicad_pcb, Power.kicad_sch]
2026-08-20 added silkscreen to help assembly process on all boards
    [Amplifier.kicad_pcb, Envelope Generator.kicad_pcb, Filter.kicad_pcb, Oscillator.kicad_pcb, Power.kicad_pcb]
2026-08-20 ran DRC on all boards
    [Amplifier.kicad_pcb, Envelope Generator.kicad_pcb, Filter.kicad_pcb, Oscillator.kicad_pcb]
2026-08-20 added protection resistor to diode ladder
    [Filter.kicad_pcb, Filter.kicad_sch]
2026-08-20 added protective resistor to op amp connecting to slide pot
    [Power.kicad_pcb, Power.kicad_sch]
2026-08-21 changed value of protective resistor in power board
    [Power.kicad_pcb, Power.kicad_sch]
2026-08-21 added graphics to some boards
    [Amplifier.kicad_pcb, Envelope Generator.kicad_pcb, Filter.kicad_pcb, Filter.kicad_sch, Oscillator.kicad_pcb]
2026-08-21 added drill/place origin to the bottom left of every board
    [Amplifier.kicad_pcb, Buttons.kicad_pcb, Envelope Generator.kicad_pcb, Filter.kicad_pcb, Oscillator.kicad_pcb, Power.kicad_pcb]
2026-08-21 preparation to merge project back into one board
    [Amplifier.kicad_pcb, Buttons.kicad_pcb, Buttons.kicad_sch, Envelope Generator.kicad_pcb, Envelope Generator.kicad_sch, Filter.kicad_pcb, Filter.kicad_sch, Main.kicad_pcb]
2026-08-21 merged project into one combined board (excluding the buttons)
    [Amplifier.kicad_pcb, Amplifier.kicad_sch, Envelope Generator.kicad_pcb, Filter.kicad_pcb, Filter.kicad_sch, Main.kicad_pcb, Main.kicad_sch, Power.kicad_pcb]
2026-08-21 made all components THT on the buttons board
    [Buttons.kicad_pcb, Buttons.kicad_sch]
